tnewman820/Smart-Mirror-UCF-SD/ATMega328P PCB/Final MCU PCB - Assembled.jpg

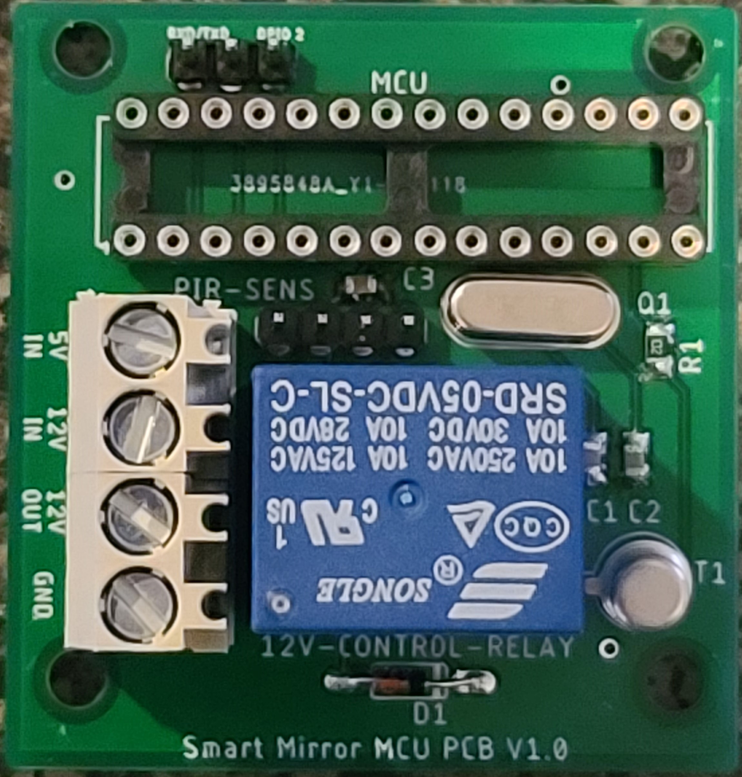
ATMega328P PCB/Final MCU PCB - Assembled.jpg
