tnewman820/Smart-Mirror-UCF-SD/ATMega328P PCB/Final MCU PCB.PNG

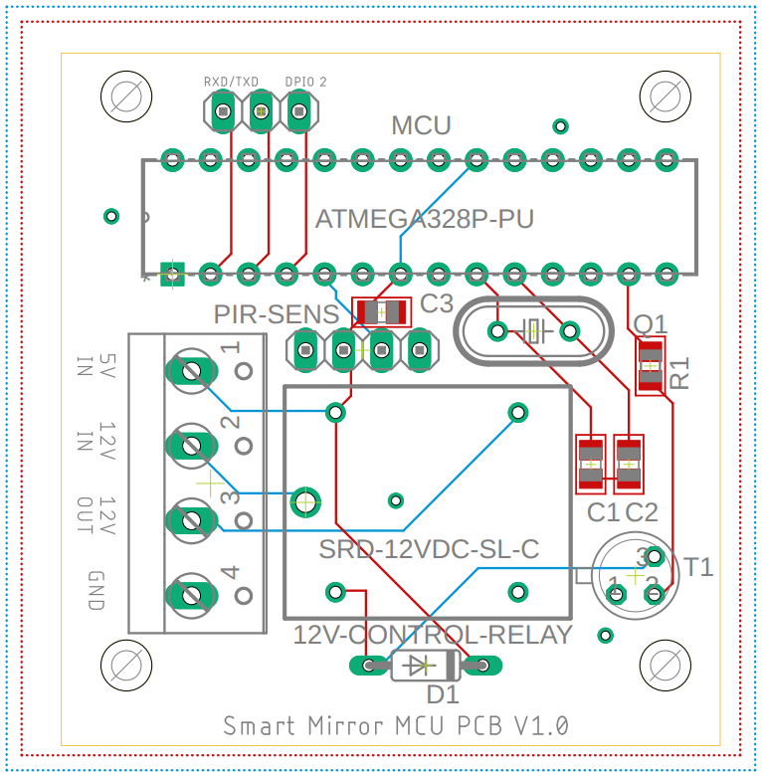
ATMega328P PCB/Final MCU PCB.PNG
