tnewman820/Smart-Mirror-UCF-SD/SD Block Diagram.png

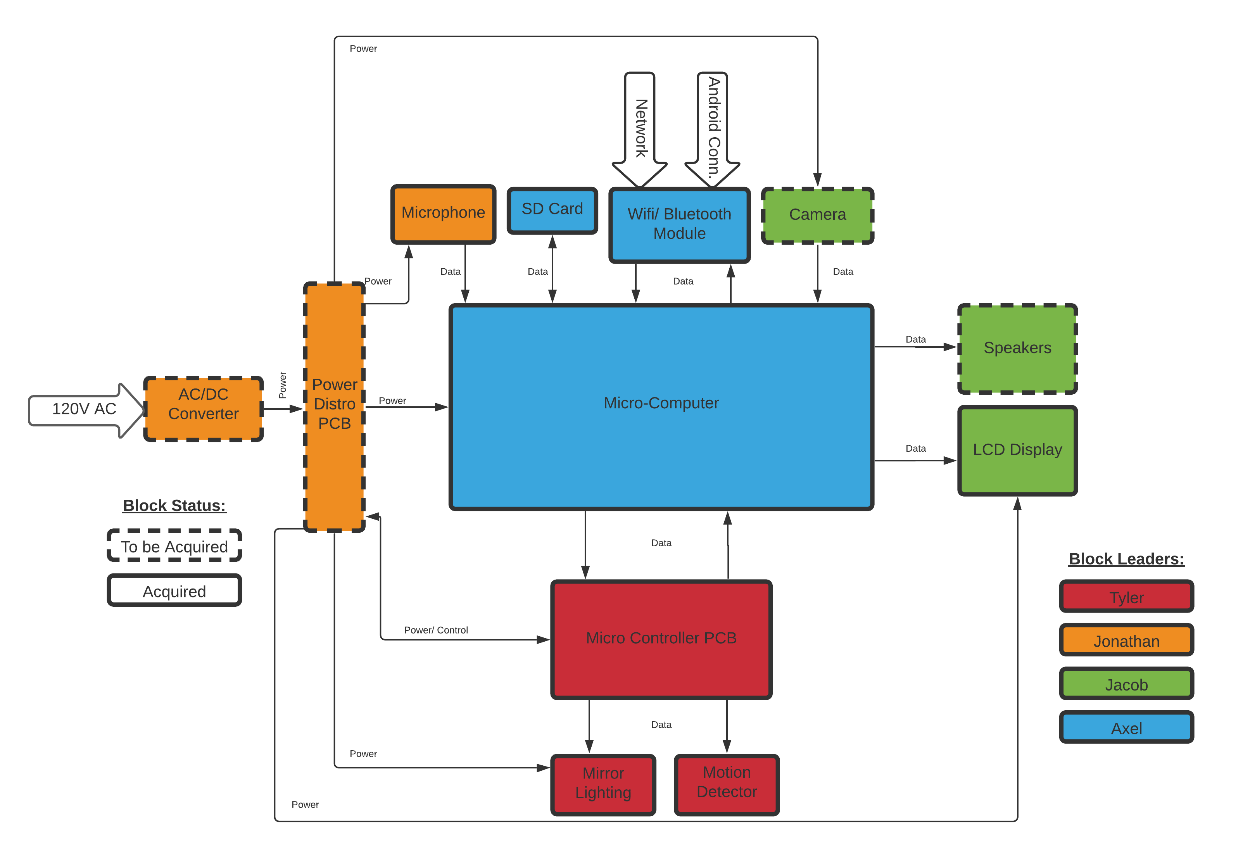
SD Block Diagram.png
