tnewman820/Smart-Mirror-UCF-SD/ATMega328P PCB/MCU-schematic.pdf

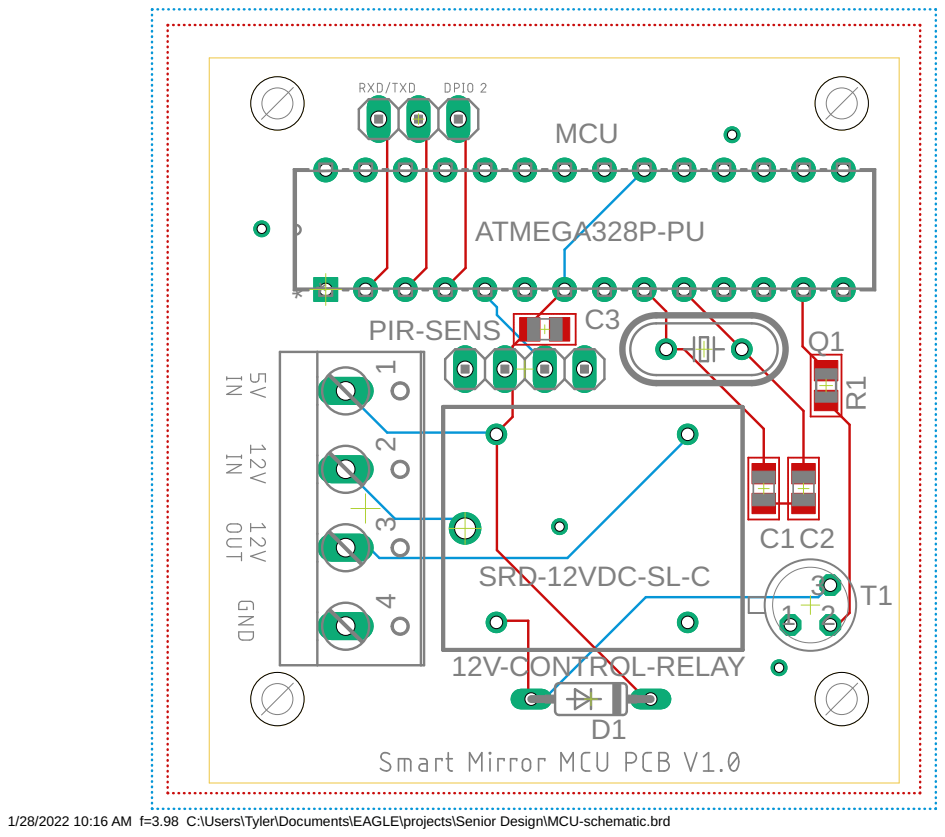
[picture p91: page 1]

1/28/2022 10:16 AM f=3.98 C:\Users\Tyler\Documents\EAGLE\projects\Senior Design\MCU-schematic.brd
