tnewman820/Smart-Mirror-UCF-SD/ATMega328P PCB/Eagle Files/MCU-schematic.brd

## EAGLE design ATMega328P PCB/Eagle Files/MCU-schematic.brd (2022-03-03)

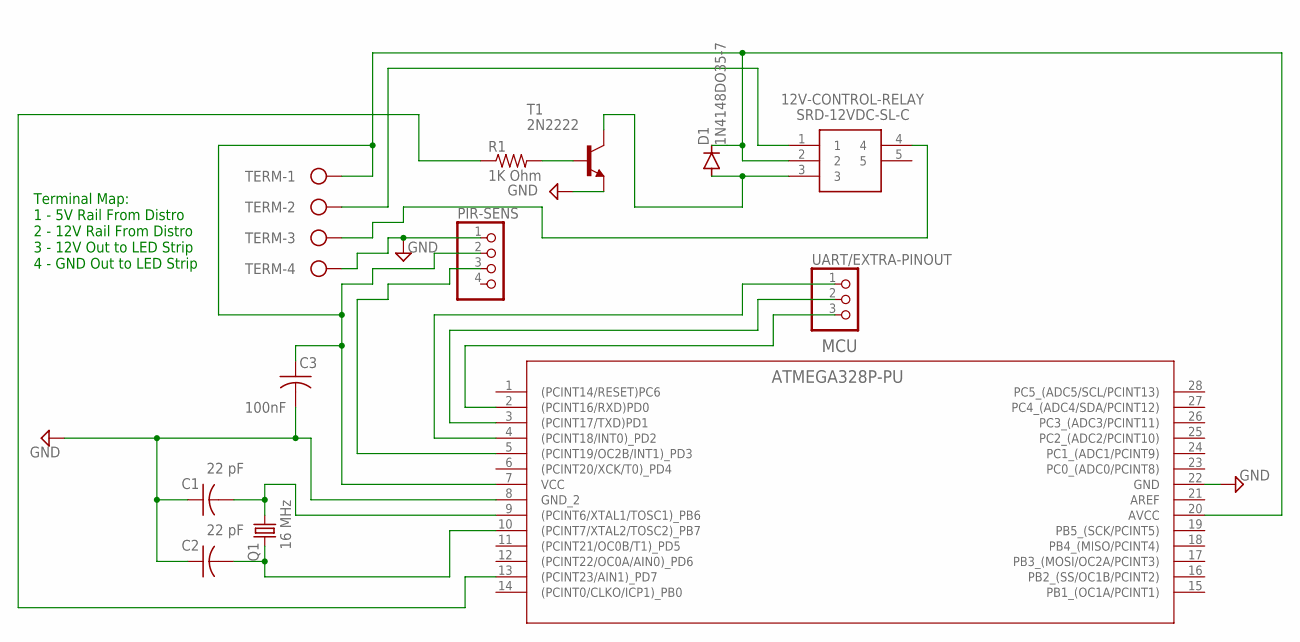
[picture p92: schematic MCU-schematic.sch]

Parts:
12V-CONTROL-RELAY: SRD-12VDC-SL-C; SRD
C1, C2: 22 pF; C0805; MPN CL21C220JBANNNC
C3: 100nF; C0805; MPN C0805C104J5RACTU
D1: 1N4148DO35-7; DO35-7
MCU: ATMEGA328P-PU; 28P3_ATM; MPN ATMEGA328P-PU
PIR-SENS: PINHD-1X4; 1X04
Q1: 16 MHz; HC49/S
R1: 1K Ohm; R0805; MPN MPZ2012S102JTD25
T1: 2N2222; TO18; MPN 2N2222
TERM: W237-4
UART/EXTRA-PINOUT: PINHD-1X3; 1X03

Connections:
GND: C1.1, C2.1, C3.2, MCU.8 (GND_2), MCU.22 (GND), PIR-SENS.1, T1.1 (E), TERM.4
unnamed: 12V-CONTROL-RELAY.4, TERM.3
unnamed: C1.2, MCU.9 ((PCINT6/XTAL1/TOSC1)_PB6), Q1.2
unnamed: C2.2, MCU.10 ((PCINT7/XTAL2/TOSC2)_PB7), Q1.1
unnamed: MCU.13 ((PCINT23/AIN1)_PD7), R1.1
unnamed: MCU.2 ((PCINT16/RXD)PD0), UART/EXTRA-PINOUT.3
unnamed: 12V-CONTROL-RELAY.1, TERM.2
unnamed: 12V-CONTROL-RELAY.2, C3.1, D1.C, MCU.7 (VCC), MCU.20 (AVCC), PIR-SENS.2, TERM.1
unnamed: MCU.5 ((PCINT19/OC2B/INT1)_PD3), PIR-SENS.3
unnamed: MCU.3 ((PCINT17/TXD)PD1), UART/EXTRA-PINOUT.2
unnamed: MCU.4 ((PCINT18/INT0)_PD2), UART/EXTRA-PINOUT.1
unnamed: 12V-CONTROL-RELAY.3, D1.A, T1.3 (C)
unnamed: R1.2, T1.2 (B)

Notes on the sheet:
Terminal Map: 1 - 5V Rail From Distro 2 - 12V Rail From Distro 3 - 12V Out to LED Strip 4 - GND Out to LED Strip

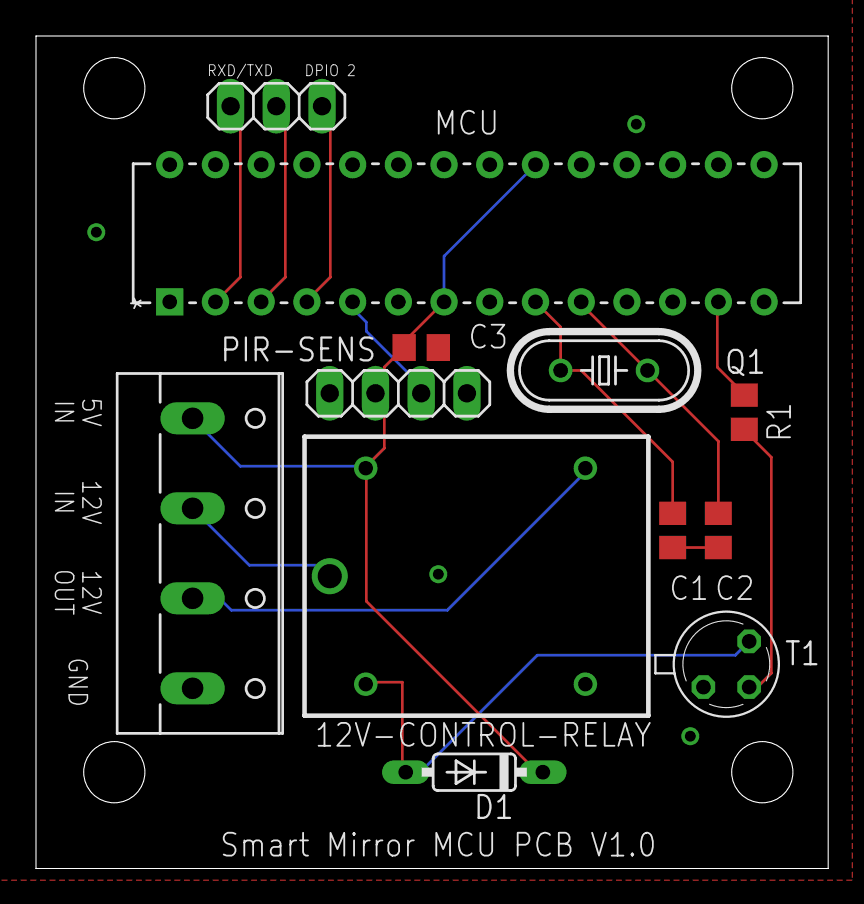
[picture p93: board MCU-schematic.brd from above]

Board: 2 copper layers, 44.0 x 46.2 mm, 12 parts (0 on the bottom side), 13 nets.
